ATLombardi/SMBusReader/board/schematic.png

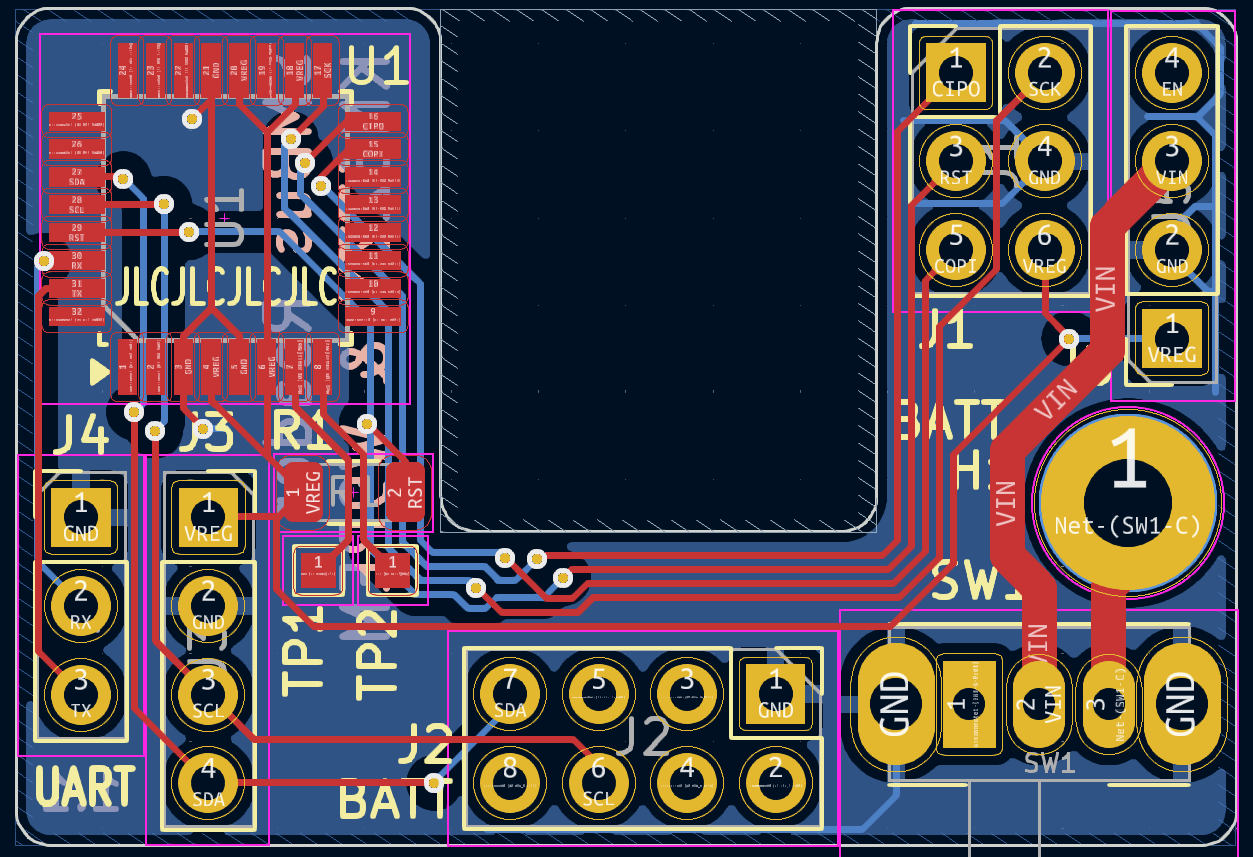
board/schematic.png
