ATLombardi/SMBusReader/board/smbus.kicad_pcb

## KiCad design board/smbus.kicad_pcb (2024-04-28)

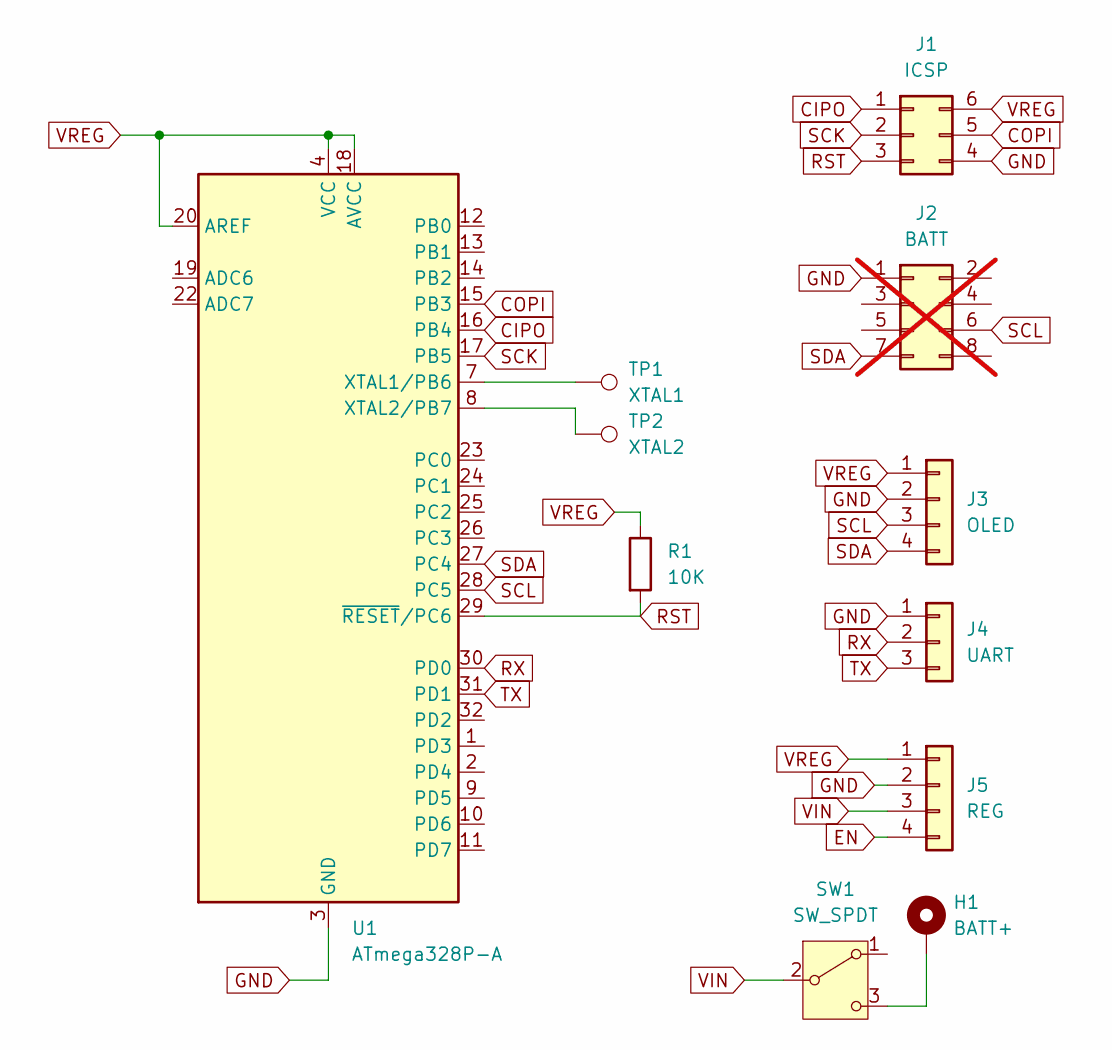
[picture p2: schematic smbus.kicad_sch]

Parts:
H1: BATT+; MountingHole_2.5mm_Pad
J1: ICSP; PinHeader_2x03_P2.54mm_Vertical; LCSC Part Number C65114
J2: BATT; PinHeader_2x04_P2.54mm_Vertical; not fitted
J3: OLED; PinSocket_1x04_P2.54mm_Vertical; LCSC Part Number C2905415
J4: UART; PinHeader_1x03_P2.54mm_Vertical; LCSC Part Number C5116482
J5: REG; PinSocket_1x04_P2.54mm_Vertical; LCSC Part Number C2905415
R1: 10K; R_1206_3216Metric; LCSC Part Number C17902
SW1: SW_SPDT; SW_Slide_SPDT_Angled_CK_OS102011MA1Q; LCSC Part Number C431547
TP1: XTAL1; TestPoint_Pad_1.0x1.0mm
TP2: XTAL2; TestPoint_Pad_1.0x1.0mm
U1: ATmega328P-A; TQFP-32_7x7mm_P0.8mm; LCSC Part Number C14877

Connections:
CIPO: J1.1, U1.16 (PB4)
COPI: J1.5, U1.15 (PB3)
EN: J5.4
GND: J1.4, J2.1, J3.2, J4.1, J5.2, U1.3 (GND), U1.5 (GND), U1.21 (GND)
unnamed: H1.1, SW1.3 (C)
unnamed: TP1.1, U1.7 (XTAL1/PB6)
unnamed: TP2.1, U1.8 (XTAL2/PB7)
RST: J1.3, R1.2, U1.29 (~RESET/PC6)
RX: J4.2, U1.30 (PD0)
SCK: J1.2, U1.17 (PB5)
SCL: J2.6, J3.3, U1.28 (PC5)
SDA: J2.7, J3.4, U1.27 (PC4)
TX: J4.3, U1.31 (PD1)
VIN: J5.3, SW1.2 (B)
VREG: J1.6, J3.1, J5.1, R1.1, U1.4 (VCC), U1.6 (VCC), U1.18 (AVCC), U1.20 (AREF)

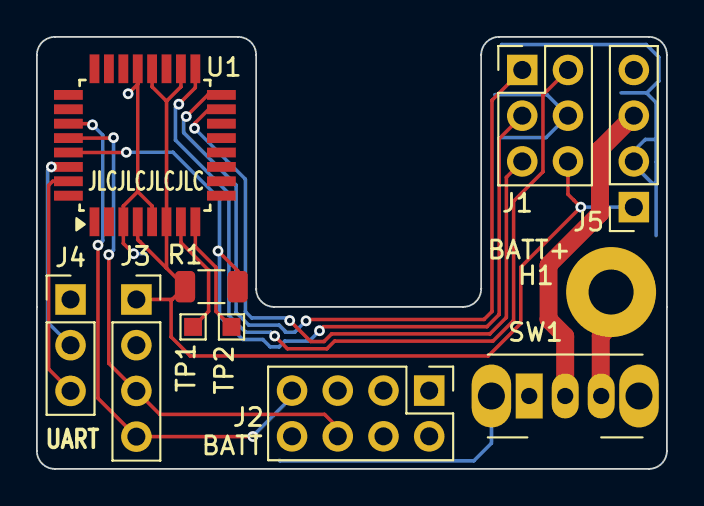
[picture p3: board smbus.kicad_pcb from above]

Board: 2 copper layers, 35.0 x 24.0 mm, 11 parts (0 on the bottom side), 14 nets.
