ATLombardi/SMBusReader/(commit log)

2024-04-28 First publish
    [smbus.kicad_pcb, smbus.kicad_sch]
2024-04-28 Assembly PDF for easier reading
2024-05-04 Fixed a bug with amperage display
    [SSD1306_BatteryReader.ino]
